fsch2/aaa_step_up/README.md

# aaa_step_up

This is a small step-up converter board small enough to replace an AAA battery. It is based on the MAX1896 DC-DC converter, which can provide up to 550 mA.

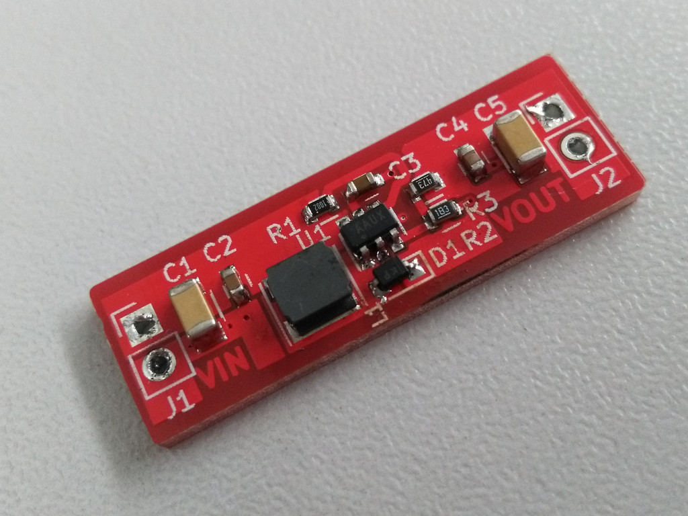
[picture p1: pics/board.jpg]
finished board
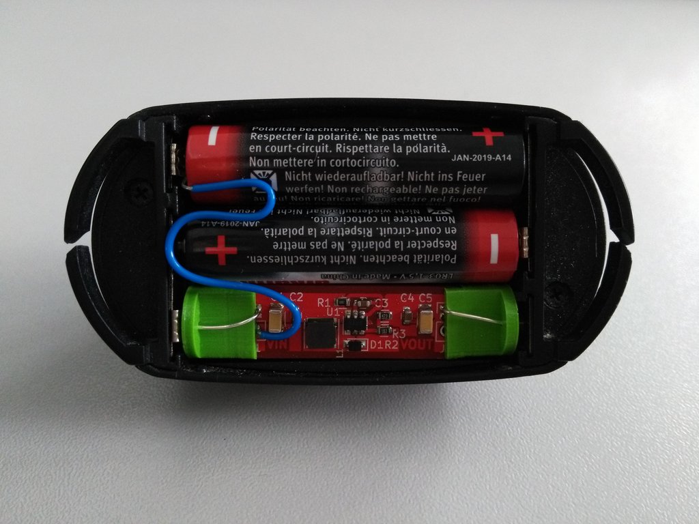
[picture p2: pics/assembled.jpg]
placed in device
