fsch2/aaa_step_up/clip/aaa_clip.FCStd

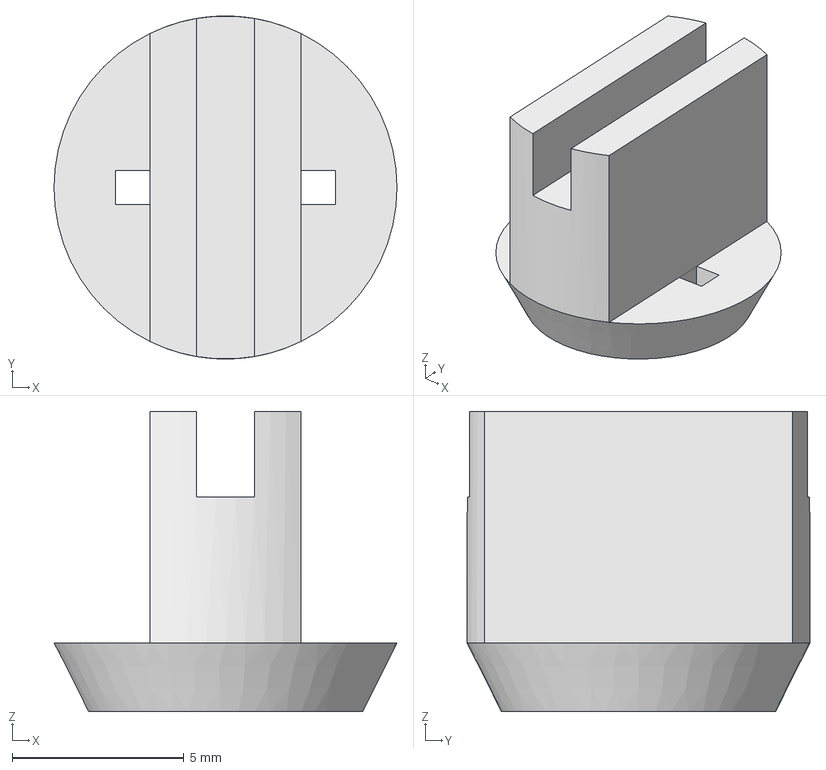
[picture p3: CAD file, 2017-09-26]
clip/aaa_clip.FCStd
10.0 x 10.0 x 8.75 mm
