fsch2/aaa_step_up/hardware/aaa_step_up.sch.pdf

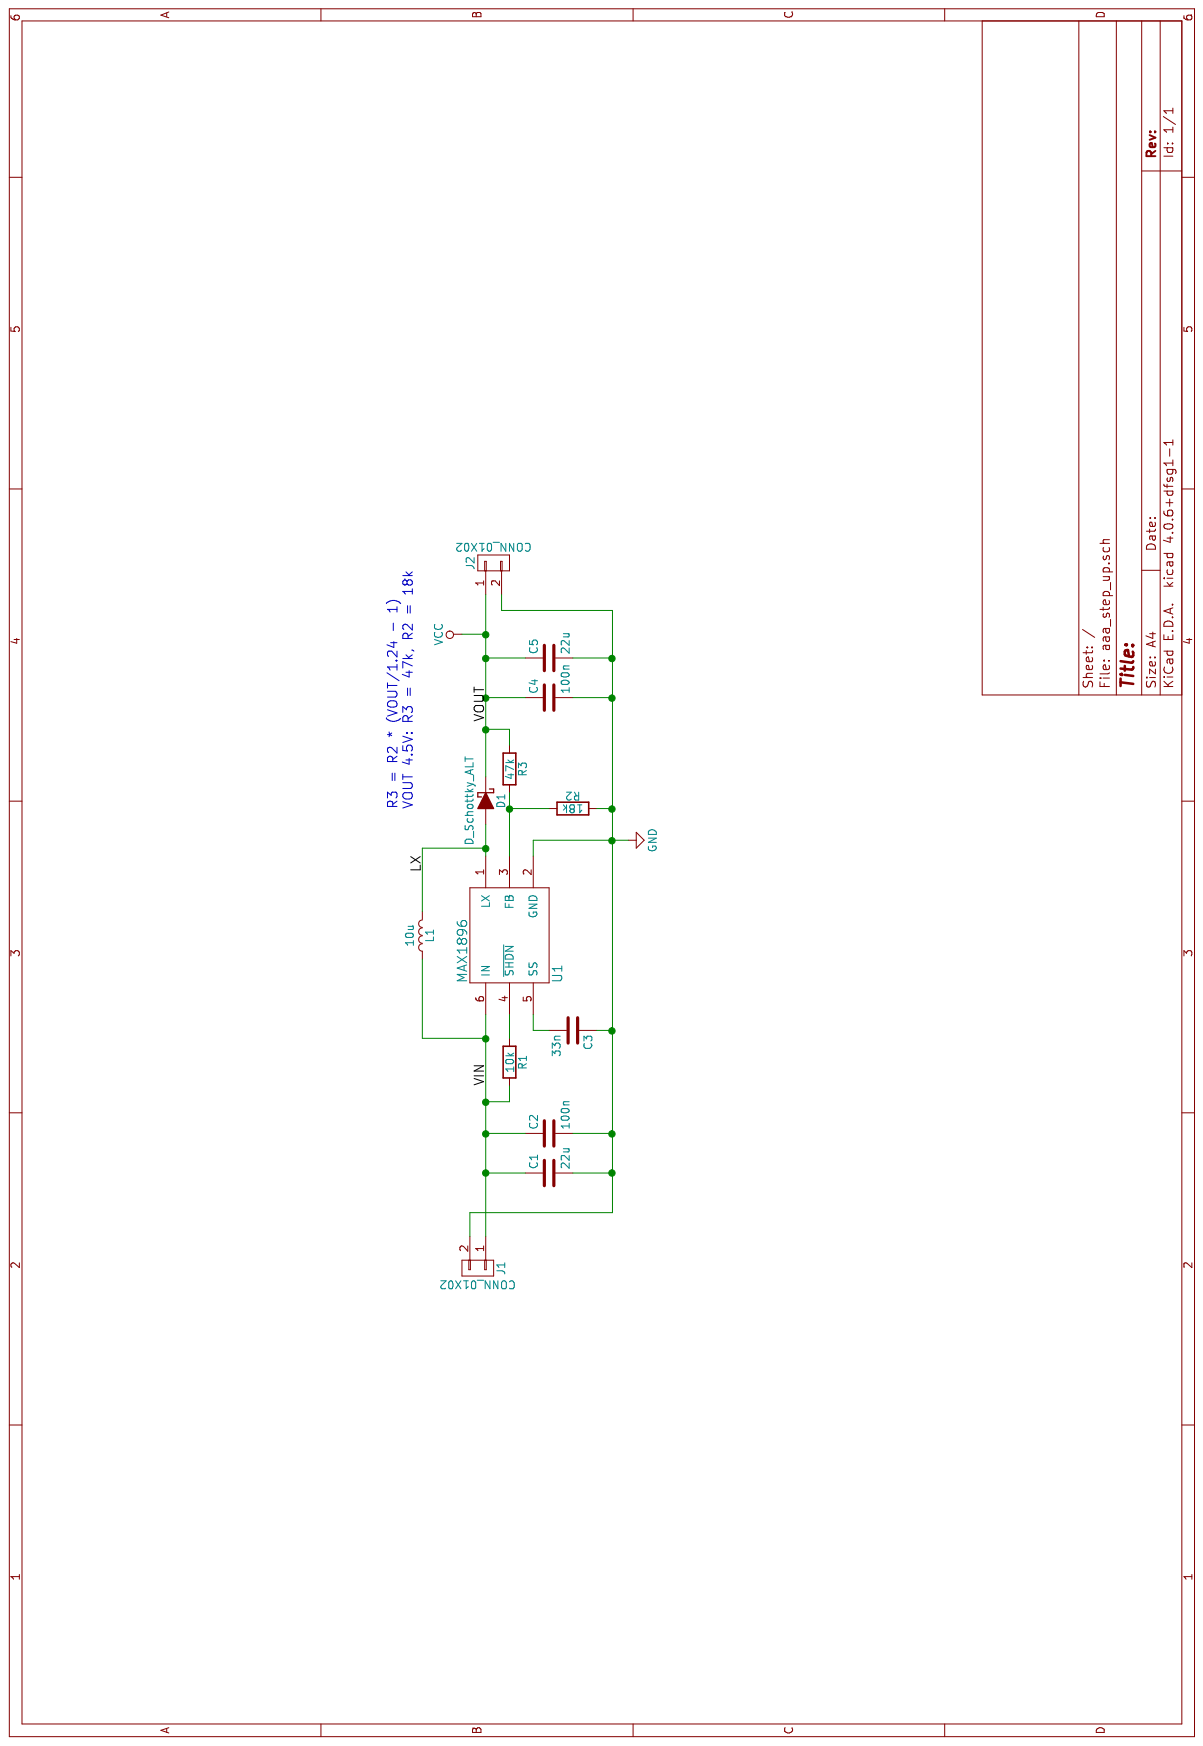
[picture p4: page 1]
