fsch2/aaa_step_up/hardware/aaa_step_up.kicad_pcb

## KiCad design hardware/aaa_step_up.kicad_pcb (2017-09-16)

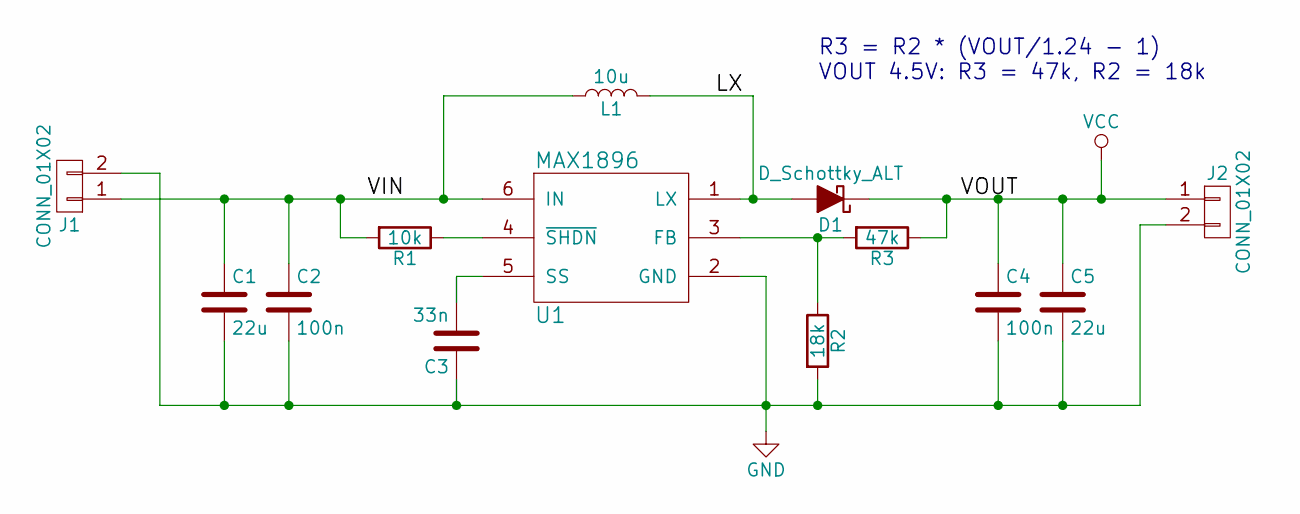
[picture p5: schematic aaa_step_up.sch]

Parts:
C1, C5: 22u; C_1206
C2, C4: 100n; C_0603
C3: 33n; C_0603
D1: D_Schottky_ALT; D_0805
J1, J2: CONN_01X02; Pin_Header_Straight_1x02_Pitch2.54mm
L1: 10u; Inductor_Taiyo-Yuden_NR-40xx
R1: 10k; R_0603
R2: 18k; R_0603
R3: 47k; R_0603
U1: MAX1896; SOT-23-6

Connections:
/LX: D1.2 (A), L1.2, U1.1 (LX)
/VIN: C1.1, C2.1, J1.1, L1.1, R1.2, U1.6 (IN)
GND: C1.2, C2.2, C3.1, C4.2, C5.2, J1.2, J2.2, R2.2, U1.2 (GND)
unnamed: C3.2, U1.5 (SS)
unnamed: R1.1, U1.4 (~SHDN)
unnamed: R2.1, R3.2, U1.3 (FB)
VCC: C4.1, C5.1, D1.1 (K), J2.1, R3.1

Notes on the sheet:
R3 = R2 * (VOUT/1.24 - 1) VOUT 4.5V: R3 = 47k, R2 = 18k

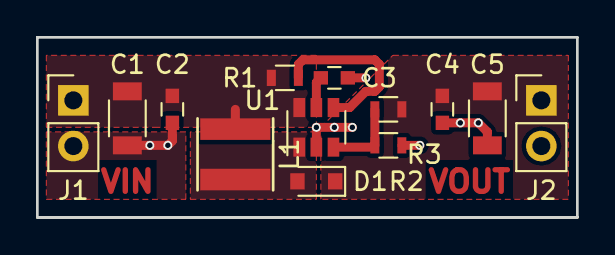
[picture p6: board aaa_step_up.kicad_pcb from above]

Board: 2 copper layers, 30.0 x 10.0 mm, 13 parts (0 on the bottom side), 7 nets.
