fsch2/aaa_step_up/(commit log)

2017-09-16 Add kicad project
    [aaa_step_up.kicad_pcb, aaa_step_up.sch]
2017-09-16 Add pics of finished board.
2017-09-16 Add PCB clip to fix board in an AAA battery holder
    [aaa_clip.FCStd]
2017-09-19 Add PDF of schematic sheet
2017-09-26 Add new version of clip with conical base
    [aaa_clip.FCStd]
